mkotyk/c128power/hardware/c128power_schematic.png

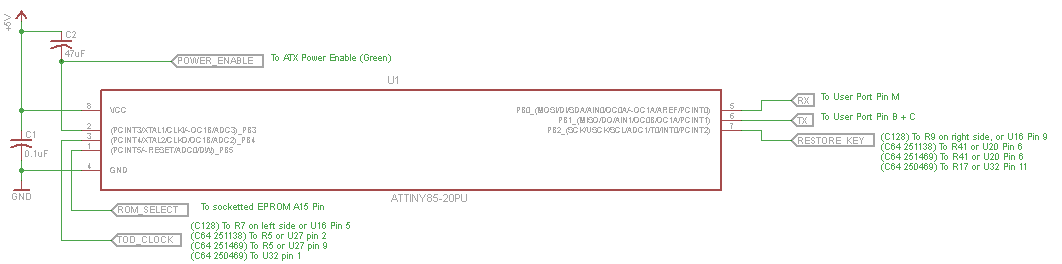
hardware/c128power_schematic.png
