mkotyk/c128power/(commit log)

2014-10-06 Added software uart routines
2014-10-08 Switched to timer1 for 60hz. using PWM for hardware gen. Sortuart working.
2014-10-10 Added photos and schematic for hardware
    [c128power.sch]
2014-10-13 Fix up help message
    [main.c]
